wumu-dot/pointer-desk/docs/features/INDEX.md

# 功能开发总览

| ID | 功能描述 | 优先级 | 当前阶段 | 总体状态 | 审查结论 | 文件 |
|----|---|---|---|---|---|---|
| FEAT-20260620-001 | SHT30 集成 — temp_mode 4页重构（天气→湿度计→双温对比→设备信息）+ pointer_set_humidity | P1 | 🟢已完成 | 🟢已完成 | ✅通过 | [FEAT-20260620-001-SHT30-温湿度传感器集成.md](FEAT-20260620-001-SHT30-温湿度传感器集成.md) |

状态图例：🔴未开始 / 🟡进行中 / 🟢已完成 / ⚠️已暂停
审查结论：待审查 / ✅通过 / ❌退回
