wumu-dot/pointer-desk/docs/bugs/BUG-20260623-002-en-overheat.md

# EN 硬接 GND 导致电机一直通电发烫

- **Bug ID**：BUG-20260623-002
- **严重等级**：P0-致命
- **发现日期**：2026-06-23
- **修复日期**：2026-06-23

## 现象描述
新 A4988 模块电机能转了，但空闲时电机持续发烫。EN 脚硬接 GND，48V 线圈持续通电。

## 复现步骤
1. EN 接 GND（低电平使能）
2. 上电后电机空闲状态
3. 10 分钟后手摸电机明显发烫

## 根因分析
EN 低电平 → A4988 始终输出电流锁住电机。即使 STEP 脉冲停止，A4988 维持线圈电流（自动半流模式）。长时间导致电机和芯片发热。

## 修复方案
- 硬件：EN 从 GND 拔下，改接 STM32 PA2
- 软件：freertos.c 中 `a4988_enable(true)` 只在 diff>10 需要移动时调用；`a4988_enable(false)` 在 diff<=10 到位后调用
- 自检结束后立即 `a4988_enable(false)` 释放电机

## 影响文件
- `firmware/Core/Src/freertos.c`（自检结束 + 正常循环 enable/disable 逻辑）
- `HANDOFF.md`、`CLAUDE.md`（接线文档更新）

## 验证方式
上电自检结束 → 电机断电（手拧不动→拧得动）→ 时钟更新角度时 diff>10 → 自动使能转完断电
