wumu-dot/pointer-desk/docs/bugs/BUG-20260610-003-sht30-missing.md

# SHT30 温湿度传感器未接

- **Bug ID**：BUG-20260610-003
- **严重等级**：P1-严重
- **发现日期**：2026-06-10
- **修复日期**：2026-06-21

## 现象描述
温度读数精度仅 ±5°C（回退至 STM32 内部 ADC），无本地湿度数据。

## 复现步骤
1. 上电运行
2. 串口日志显示 `[SHT30] Device not found at 0x44 (I2C2)`
3. `temp_sensor_read()` 回退到 `temp_adc_read_celsius()`（内部 ADC）

## 根因分析
SHT30 传感器硬件未连接。驱动程序完整（`temp_sensor.c`），自动探测失败后优雅降级至内部 ADC。

## 修复方案
SHT30 已到货，2026-06-21 完成接线和验证：
- **PF1 = SCL**、**PF0 = SDA**（I2C2，100kHz）
- 供电：面包板 +轨 3.3V，地址：0x44
- temp_mode 同步升级为 4 页架构（天气/湿度计/双温对比/设备信息）
- FEAT-20260620-001 记录完整实施过程

**无需改驱动**。`sht30_init()` 上电自动探测，检测到即切换为 ±0.3°C 精度。

## 影响文件
- 无（驱动已就绪，插上即用）

## 验证方式
接好 SHT30 后上电，串口日志显示 `[SHT30] Device detected at 0x44 (I2C2)` 和 `[TEMP] Selected SHT30 (external, ±0.3°C)`。已验证通过。
