wumu-dot/pointer-desk/docs/bugs/BUG-20260610-001-tft-tearing.md

# TFT 显示闪烁（撕裂/Tearing）

- **Bug ID**：BUG-20260610-001
- **严重等级**：P0-阻断
- **发现日期**：2026-06-10
- **修复日期**：—

## 现象描述
时钟每秒刷新时，屏幕可见闪烁/撕裂线。

## 复现步骤
1. 上电运行，观察时钟模式每秒刷新
2. 可见水平撕裂线随秒刷新移动

## 根因分析
ST7735S 支持 TE（Tearing Effect）硬件同步信号（芯片第 14 脚），但 1.8 寸公版模块**未引出 TE 引脚**到排针。无 TE 信号时，SPI 写入 GRAM 与面板扫描异步 → 必然撕裂。

已尝试的软件缓解（均无法根治）：SPI 降频 21→10.5MHz、帧缓冲+选择性渲染（每秒只 flush ~2.3KB）、脏矩形合并。

## 修复方案
1. **飞线 TE 引脚**（推荐）：ST7735S 第 14 脚飞线到 STM32 空闲 GPIO，`flush_rect()` 前轮询 TE
2. 提高刷新率至 20FPS（功耗增加）
3. 接受现状（公版模块硬件限制）

## 影响文件
- `firmware/Drivers/BSP/lcd/st7735.c`
- `firmware/Drivers/BSP/lcd/st7735.h`

## 验证方式
飞线后：肉眼观察无撕裂线；20FPS 模式：串口日志帧率 ≥20
