wumu-dot/pointer-desk/docs/bugs/BUG-20260610-002-rtc-power-loss.md

# RTC 断电后时间丢失

- **Bug ID**：BUG-20260610-002
- **严重等级**：P3-轻微
- **发现日期**：2026-06-10
- **修复日期**：—

## 现象描述
断电后 RTC 时间归零，需重新编译/烧录注入时间。

## 复现步骤
1. 上电运行，确认时间正常
2. 完全断电（拔掉 Type-C + 3.3V）
3. 重新上电，RTC 时间归零

## 根因分析
VBAT 引脚未接备用电池，主电源断电后 RTC 寄存器和备份域全部丢失。

## 修复方案
接 CR1220 纽扣电池（3V）到 VBAT 引脚（LQFP144 第 6 脚），正极→VBAT，负极→GND。

**已缓解**：ESP32 NTP 每 60s 通过 UART 校准 STM32 RTC，上电后 60s 内自动对时。

## 影响文件
- 无代码改动（纯硬件）

## 验证方式
断电 1 分钟后重新上电，观察串口日志中 `weather frame` 到来前后的时间变化
