wumu-dot/pointer-desk/firmware/Core/Src/main.c

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
/* Includes ------------------------------------------------------------------*/
#include "main.h"
#include "cmsis_os.h"

/* USER CODE BEGIN Includes */
#include "pin_config.h"
#include "app_config.h"
#include "st7735.h"
#include "w25q64.h"
#include "a4988.h"
#include "button.h"
#include "temp_sensor.h"
#include "rtc_drv.h"
#include "gui.h"
#include "pointer_engine.h"
#include "fs_mgr.h"
#include "mode_manager.h"
#include "tasks.h"
/* USER CODE END Includes */

ADC_HandleTypeDef hadc1;

I2C_HandleTypeDef hi2c2;

RTC_HandleTypeDef hrtc;

SPI_HandleTypeDef hspi1;
SPI_HandleTypeDef hspi2;

TIM_HandleTypeDef htim2;
TIM_HandleTypeDef htim3;
TIM_HandleTypeDef htim4;
TIM_HandleTypeDef htim5;

UART_HandleTypeDef huart1;

/* Definitions for TaskButton */
osThreadId_t TaskButtonHandle;
const osThreadAttr_t TaskButton_attributes = {
  .name = "TaskButton",
  .stack_size = 512 * 4,
  .priority = (osPriority_t) osPriorityHigh,
};
/* Definitions for TaskBG */
osThreadId_t TaskBGHandle;
const osThreadAttr_t TaskBG_attributes = {
  .name = "TaskBG",
  .stack_size = 2048 * 4,
  .priority = (osPriority_t) osPriorityNormal,
};
/* Definitions for TaskDisplay */
osThreadId_t TaskDisplayHandle;
const osThreadAttr_t TaskDisplay_attributes = {
  .name = "TaskDisplay",
  .stack_size = 2048 * 4,
  .priority = (osPriority_t) osPriorityNormal,
};
/* Definitions for TaskMotor */
osThreadId_t TaskMotorHandle;
const osThreadAttr_t TaskMotor_attributes = {
  .name = "TaskMotor",
  .stack_size = 1024 * 4,
  .priority = (osPriority_t) osPriorityNormal,
};
/* Definitions for QueueBtnEvents */
osMessageQueueId_t QueueBtnEventsHandle;
const osMessageQueueAttr_t QueueBtnEvents_attributes = {
  .name = "QueueBtnEvents"
};
/* Definitions for QueueRenderCmds */
osMessageQueueId_t QueueRenderCmdsHandle;
const osMessageQueueAttr_t QueueRenderCmds_attributes = {
  .name = "QueueRenderCmds"
};
/* Definitions for QueueMotorTargets */
osMessageQueueId_t QueueMotorTargetsHandle;
const osMessageQueueAttr_t QueueMotorTargets_attributes = {
  .name = "QueueMotorTargets"
};
/* Definitions for EvtMotor */
osEventFlagsId_t EvtMotorHandle;
const osEventFlagsAttr_t EvtMotor_attributes = {
  .name = "EvtMotor"
};
/* USER CODE BEGIN PV */
UART_HandleTypeDef huart2;
DMA_HandleTypeDef hdma_usart2_rx;

/* USART2 DMA 接收缓冲区 (ESP32 天气桥接) */
uint8_t  uart2_rx_buf[256];
char     uart2_line_buf[128];
uint8_t  uart2_line_pos;
uint32_t uart2_dma_prev;

weather_data_t g_weather;

/* SPI1 DMA TX handle — needed by stm32f4xx_it.c DMA2_Stream3_IRQHandler */
DMA_HandleTypeDef hdma_spi1_tx;
/* USER CODE END PV */

void SystemClock_Config(void);
static void MX_GPIO_Init(void);
static void MX_SPI1_Init(void);
static void MX_SPI2_Init(void);
static void MX_TIM2_Init(void);
static void MX_TIM3_Init(void);
static void MX_TIM4_Init(void);
static void MX_ADC1_Init(void);
static void MX_I2C2_Init(void);
static void MX_RTC_Init(void);
static void MX_TIM5_Init(void);
static void MX_USART1_UART_Init(void);
static void MX_USART2_UART_Init(void);
void StartTaskButton(void *argument);
void StartTaskBG(void *argument);
void StartTaskDisplay(void *argument);
void StartTaskMotor(void *argument);

/**
  * @brief  The application entry point.
  * @retval int
  */
int main(void)
{

  /* MCU Configuration--------------------------------------------------------*/

  /* Reset of all peripherals, Initializes the Flash interface and the Systick. */
  HAL_Init();

  /* Configure the system clock */
  SystemClock_Config();

  /* Initialize all configured peripherals */
  MX_GPIO_Init();
  MX_SPI1_Init();
  MX_SPI2_Init();
  MX_TIM2_Init();
  MX_TIM3_Init();
  MX_TIM4_Init();
  MX_ADC1_Init();
  MX_I2C2_Init();
  MX_RTC_Init();
  MX_TIM5_Init();
  MX_USART1_UART_Init();
  MX_USART2_UART_Init();
  /* USER CODE BEGIN 2 */
  LOG("========== OV-Watch Firmware v1.0.0 ==========\r\n");
  LOG("System Core Clock: %lu MHz\r\n", SystemCoreClock / 1000000);

  /* ---- USART2 DMA 启动 — ESP32 天气数据 ---- */
  HAL_UART_Receive_DMA(&huart2, uart2_rx_buf, sizeof(uart2_rx_buf));

  /* ---- BSP 驱动初始化 ---- */
  st7735_init();
  button_init();
  a4988_init();
  temp_sensor_init();
  /* w25q64 由 fs_mgr 模块延迟检测 (FreeRTOS 启动后) */

  /* ---- 中间件初始化 ---- */
  gui_init();
  pointer_engine_init();

  /* ---- 应用层初始化 ---- */
  mode_manager_init();

  /* ---- 背光 PWM 启动 ---- */
  HAL_TIM_PWM_Start(&htim3, TIM_CHANNEL_3);
  st7735_set_brightness(LCD_BRIGHTNESS_DEFAULT);

  LOG("Hardware init complete, starting scheduler...\r\n");
  /* USER CODE END 2 */

  /* Init scheduler */
  osKernelInitialize();

  /* USER CODE BEGIN RTOS_MUTEX */
  /* add mutexes, ... */
  /* USER CODE END RTOS_MUTEX */

  /* USER CODE BEGIN RTOS_SEMAPHORES */
  /* add semaphores, ... */
  /* USER CODE END RTOS_SEMAPHORES */

  /* USER CODE BEGIN RTOS_TIMERS */
  /* start timers, add new ones, ... */
  /* USER CODE END RTOS_TIMERS */

  /* Create the queue(s) */
  /* creation of QueueBtnEvents */
  QueueBtnEventsHandle = osMessageQueueNew (8, 8, &QueueBtnEvents_attributes);

  /* creation of QueueRenderCmds */
  QueueRenderCmdsHandle = osMessageQueueNew (16, 16, &QueueRenderCmds_attributes);

  /* creation of QueueMotorTargets */
  QueueMotorTargetsHandle = osMessageQueueNew (4, 12, &QueueMotorTargets_attributes);

  /* USER CODE BEGIN RTOS_QUEUES */
  /* add queues, ... */
  /* USER CODE END RTOS_QUEUES */

  /* Create the thread(s) */
  /* creation of TaskButton */
  TaskButtonHandle = osThreadNew(StartTaskButton, NULL, &TaskButton_attributes);

  /* creation of TaskBG */
  TaskBGHandle = osThreadNew(StartTaskBG, NULL, &TaskBG_attributes);

  /* creation of TaskDisplay */
  TaskDisplayHandle = osThreadNew(StartTaskDisplay, NULL, &TaskDisplay_attributes);

  /* creation of TaskMotor */
  TaskMotorHandle = osThreadNew(StartTaskMotor, NULL, &TaskMotor_attributes);

  /* USER CODE BEGIN RTOS_THREADS */
  /* add threads, ... */
  /* USER CODE END RTOS_THREADS */

  /* Create the event(s) */
  /* creation of EvtMotor */
  EvtMotorHandle = osEventFlagsNew(&EvtMotor_attributes);

  /* USER CODE BEGIN RTOS_EVENTS */
  /* add events, ... */
  /* USER CODE END RTOS_EVENTS */

  /* Start scheduler */
  osKernelStart();

  /* We should never get here as control is now taken by the scheduler */

  /* Infinite loop */
  /* USER CODE BEGIN WHILE */
  while (1)
  {
    /* USER CODE END WHILE */

    /* USER CODE BEGIN 3 */
  }
  /* USER CODE END 3 */
}

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
/* USER CODE BEGIN 4 */
#include <stdio.h>

/* printf 重定向到 USART1 (Keil ARMCC + GCC 通用) */
#if defined(__GNUC__) && !defined(__CC_ARM)
/* GCC / Newlib-nano */
int _write(int fd, char *ptr, int len) {
    HAL_UART_Transmit(&huart1, (uint8_t *)ptr, len, HAL_MAX_DELAY);
    return len;
}
#else
/* Keil ARMCC (MicroLIB 或标准库) */
int fputc(int ch, FILE *f) {
    (void)f;
    HAL_UART_Transmit(&huart1, (uint8_t *)&ch, 1, HAL_MAX_DELAY);
    return ch;
}
#endif
/* USER CODE END 4 */

/* USER CODE BEGIN Header_StartTaskButton */
/**
  * @brief  Function implementing the TaskButton thread.
  * @param  argument: Not used
  * @retval None
  */
/* USER CODE END Header_StartTaskButton */

/* GCC: StartTask* implementations live in freertos.c.
   ARMCC: CubeMX stubs in main.c (Keil uses freertos.c too, but linker picks
   the first definition — ARMCC linker semantics differ from GCC). */
#ifndef __GNUC__

void StartTaskButton(void *argument)
{
  /* USER CODE BEGIN 5 */
  /* Infinite loop */
  for(;;)
  {
    osDelay(1);
  }
  /* USER CODE END 5 */
}

/* USER CODE BEGIN Header_StartTaskBG */
/**
* @brief Function implementing the TaskBG thread.
* @param argument: Not used
* @retval None
*/
/* USER CODE END Header_StartTaskBG */
void StartTaskBG(void *argument)
{
  /* USER CODE BEGIN StartTaskBG */
  /* Infinite loop */
  for(;;)
  {
    osDelay(1);
  }
  /* USER CODE END StartTaskBG */
}

/* USER CODE BEGIN Header_StartTaskDisplay */
/**
* @brief Function implementing the TaskDisplay thread.
* @param argument: Not used
* @retval None
*/
/* USER CODE END Header_StartTaskDisplay */
void StartTaskDisplay(void *argument)
{
  /* USER CODE BEGIN StartTaskDisplay */
  /* Infinite loop */
  for(;;)
  {
    osDelay(1);
  }
  /* USER CODE END StartTaskDisplay */
}

/* USER CODE BEGIN Header_StartTaskMotor */
/**
* @brief Function implementing the TaskMotor thread.
* @param argument: Not used
* @retval None
*/
/* USER CODE END Header_StartTaskMotor */
void StartTaskMotor(void *argument)
{
  /* USER CODE BEGIN StartTaskMotor */
  /* Infinite loop */
  for(;;)
  {
    osDelay(1);
  }
  /* USER CODE END StartTaskMotor */
}

#endif /* !__GNUC__ */

/**
  * @brief  Period elapsed callback in non blocking mode
  * @note   This function is called  when TIM6 interrupt took place, inside
  * HAL_TIM_IRQHandler(). It makes a direct call to HAL_IncTick() to increment
  * a global variable "uwTick" used as application time base.
  * @param  htim : TIM handle
  * @retval None
  */
void HAL_TIM_PeriodElapsedCallback(TIM_HandleTypeDef *htim)
{
  if (htim->Instance == TIM6)
  {
    HAL_IncTick();
  }
}

/**
  * @brief  This function is executed in case of error occurrence.
  * @retval None
  */
void Error_Handler(void)
{
  /* USER CODE BEGIN Error_Handler_Debug */
  /* User can add his own implementation to report the HAL error return state */
  __disable_irq();
  while (1)
  {
  }
  /* USER CODE END Error_Handler_Debug */
}
#ifdef USE_FULL_ASSERT
/**
  * @brief  Reports the name of the source file and the source line number
  *         where the assert_param error has occurred.
  * @param  file: pointer to the source file name
  * @param  line: assert_param error line source number
  * @retval None
  */
void assert_failed(uint8_t *file, uint32_t line)
{
  /* USER CODE BEGIN 6 */
  /* User can add his own implementation to report the file name and line number,
     ex: printf("Wrong parameters value: file %s on line %d\r\n", file, line) */
  /* USER CODE END 6 */
}
#endif /* USE_FULL_ASSERT */
