wumu-dot/pointer-desk/firmware/Core/Inc/main.h

#define CS_Pin GPIO_PIN_4
#define CS_GPIO_Port GPIOA
#define DC_Pin GPIO_PIN_4
#define DC_GPIO_Port GPIOC
#define RST_Pin GPIO_PIN_5
#define RST_GPIO_Port GPIOC
#define CSB12_Pin GPIO_PIN_12
#define CSB12_GPIO_Port GPIOB
