wumu-dot/pointer-desk/(commit log)

2026-06-15 ov-watch: 固件编译通过 + 18个运行时bug修复 + 单键适配
    ## 编译修复
    - main.c 删除CubeMX空壳函数定义, 用freertos.c实现
    - uvprojx 关闭DebugInformation (ARMCC V5 32位 out of store)
    - fs_mgr.c em dash → ASCII
    - gui.c 0b二进制 → 0x十六进制 (ARMCC不支持0b)
    - temp_adc.c ADC_REGULAR_RANK_1 → 1 (F4无此宏)
    - a4988.c BRR→BSRR, 宏→寄存器
    - st7735.c 移除unused变量, w25q64.c注释unused函数
    - 4个mode头文件添加 #include "button.h"
    ## 运行时修复
    - #17 st7735_draw_char 字模行列颠倒修正
    - #18 pointer_set_target LOG去重
    - #19 clock_mode_render 冗余脏矩形标记清理
    - #20 freertos.c 电机反馈回路删除 (指针不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
    [app_config.h, clock_mode.c, clock_mode.h, main.c, main.h, mode_manager.c, mode_manager.h, ov-watch.ioc]
2026-06-17 docs: esp32 weather bridge design spec
2026-06-17 docs: esp32 weather bridge implementation plan (16 tasks, 4 phases)
2026-06-17 fix(fs_mgr): Flash 空间泄漏 — fs_config_save 由强制追加改为原地覆写
    根因: fs_config_save() 无条件使用 g_next_data_offset 写入数据，
    每次保存配置文件都追加到队尾，旧数据原地废弃。g_next_data_offset
    只进不退，导致配置区空间被无意义消耗。
    修复:
    - 已存在且新数据 ≤ 旧数据大小 → 原地覆写，不推进偏移
    - 新增 key 或数据变大 → 追加到队尾，推进偏移
    - 空间检查仅对追加写入场景执行
    - LOG 追加 [new]/[grew]/[in-place] 标记，方便调试
    其他改动:
    - 新增交接文档 (HANDOFF.md)、Bug 清单 (BUGS.md)
    - 新增 weather_bridge.c/h (ESP32 UART 天气桥接 DMA 解析)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
    [app_config.h, clock_mode.c, main.c, main.h, mode_manager.c, pin_config.h, settings_mode.c, temp_mode.c]
2026-06-20 chore: 项目结构清理 + Bug体系迁移 + 文档重构
    项目结构：
    - 删除 firmware/EWARM/ (IAR项目，本项目用Keil MDK)
    - 删除 firmware/Middlewares/ (FreeRTOS冗余副本，由Keil RTE管理)
    - 删除 START_HERE.md (过时，内容已由README+HANDOFF覆盖)
    - 删除 docs/cubemx-setup.md + docs/stm32f407-constraints.md (引脚信息错误)
    Bug体系迁移：
    - BUGS.md (155行单文件) → docs/bugs/ (一Bug一文件 + INDEX.md)
    - 8个未修复 + 1个已修复 + 模板
    文档重构：
    - CLAUDE.md 重写为项目地图 (技术栈/目录速查/约束/规范索引)
    - HANDOFF.md 更新v1.4.1 (清理记录/电机SHT30状态/A4988数据手册)
    - README.md 重写为精简版
    -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
2026-06-20 fix: 恢复 FreeRTOS 源码 — Keil 工程引用本地路径非 RTE Pack
    之前清理时误删 firmware/Middlewares/Third_Party/FreeRTOS/Source/，
    以为 Keil RTE Pack 管理了这些文件。实际上 ov-watch.uvprojx 直接引用
    ../Middlewares/Third_Party/FreeRTOS/Source/ 本地路径，删除后编译报
    'cannot open source input file' ×12。
    修正 CLAUDE.md 中错误描述："FreeRTOS 源码副本，由 Keil RTE Pack 管理"
    → "FreeRTOS 源码，Keil 工程直接引用本地路径，勿删"。
2026-06-20 feat: SHT30 温湿度传感器集成 — temp_mode 4页架构重构
    FEAT-20260620-001 完成。SHT30 已接线验证通过 (I2C2 PF0/PF1 0x44)。
    代码改动:
    - pointer_engine.h/c: 新增 pointer_set_humidity() — 0-100% 映射 30°-330° 弧线
    - temp_mode.c: bool→enum 4页架构 (天气→湿度计→双温对比→设备信息)
    - 湿度计子页: SHT30 本地湿度 → 大字+等级标签+湿度环+指针
    - 双温对比子页: LOCAL(SHT30) vs REGIONAL(ESP32) 温度+湿度+温差
    - SHT30 离线降级: 湿度计显示 '--%' + 'No SHT30'
    双温对比 LOCAL 显示 '--.-' + 'None'
    测试:
    - TC01 SHT30在线: 4页全正常，指针角度正确
    - TC02 SHT30离线: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
2026-06-20 docs: README 重写 — 更名为 pointer-desk，更新项目状态
    反映 SHT30 已完成、4页架构已就绪，新增功能看板链接。
    待实现项: 电机验证 / 番茄钟 / 呼吸引导 / 日出日落环
2026-06-20 docs: README 加个人后记 — AI 协作心得
2026-06-20 docs: FEAT 模板升级 v3.1 — 5阶段重命名 + 12条AC + 阶段间停等
    阶段重命名 (更语义化):
    阶段1 基础框架搭建 → 准备 (分析依赖, 输出影响范围)
    阶段2 核心业务逻辑 → 设计 (数据结构, 接口签名)
    阶段3 集成与自测 → 实现 (写代码, 对照AC自检)
    阶段4 独立测试 → 测试 (只看规格, 不看实现)
    阶段5 独立审查 → 审查 (安全检查/质量/规范 唯一下闸)
    新增:
    - 每个阶段末尾加 ⏸️ 停等标记 (阶段间必须等人说继续)
    - AC 从 11 条扩展为 12 条 (AC-12: 按 FEAT 模板执行)
    - AC-03/04 拆分: 编译Lint / 无新增警告
    - AC-05 函数行数 →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
2026-06-20 ci: GitHub Actions 质量门禁 — 4道自动检查
    每次 push 到 C 源文件自动触发:
    Job 1: check-firmware.sh (18项回归)
    Job 2: 硬编码密钥扫描 (sk-xxx / API_KEY / password / token)
    Job 3: 危险函数扫描 (sprintf/strcpy/strcat/gets/scanf — 排除vendor)
    Job 4: 文件行数检查 (max 800行 — 排除CubeMX main.c + vendor)
    仅扫描项目代码 (App/Core/BSP/Middleware)，排除 FreeRTOS/CMSIS/HAL。
2026-06-20 fix: CI 移除 path filter — 首次创建工作流文件不触发
2026-06-21 feat(build): 迁移到 STM32CubeCLT (GCC) — 脱离 Keil 许可证
    CubeMX 切换 Toolchain: MDK-ARM → Makefile
    - Makefile (CubeMX 生成 + 自定义源文件/头文件路径)
    - startup_stm32f407xx.s (GCC 汇编启动文件)
    - STM32F407XX_FLASH.ld (链接脚本)
    - build_and_flash.bat (一键编译+烧录)
    - syscalls.c / sysmem.c (GCC semihosting stubs)
    - FreeRTOS GCC port (portable/GCC/ARM_CM4F)
    修改:
    - main.c: StartTask* stubs 加 __ARMCC_VERSION guard
    - main.c: 补充 hdma_spi1_tx 定义
    - CLAUDE.md: 编译命令补充 GCC 工具链
    编译: arm-none-eabi-gcc 14.3.1 → 0 Error
    硬件验证: SHT30/TFT/Flash/RTC/按键 全部正常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
    [main.c, ov-watch.ioc]
2026-06-21 ci: Quality Gate 新增 Job 5 — GCC 编译验证
    make -j(nproc) 每次 push 自动编译 STM32F407 固件。
    使用 Ubuntu APT 的 gcc-arm-none-eabi 工具链 (~250MB)。
    现在 5 道检查:
    1. check-firmware.sh (18项回归)
    2. 硬编码密钥扫描
    3. 危险函数扫描
    4. 文件行数检查
    5. GCC 编译 ✅ ← 新增
2026-06-21 fix(ci): check-firmware.sh StartTask 检查适配 GCC guard
    GCC 迁移后 main.c 中 StartTask* 函数体被 #ifndef __GNUC__ 包裹
    (ARMCC-only stubs)。旧检查将所有非声明行一律判 FAIL。
    修复: 检查 StartTask 体是否在 GCC guard 内 — 在则 PASS。
2026-06-21 fix(build): 恢复 USART2 初始化和 DMA — CubeMX 重新生成后丢失
    CubeMX 不知道 ESP32 天气桥接用的 USART2 (手动添加的外设)，
    切换 Makefile 重新生成时删除了:
    - main.c: MX_USART2_UART_Init() 函数和调用
    - hal_msp.c: USART2 GPIO/DMA 初始化 (PD5/PD6, DMA1_Stream5)
    恢复后 ESP32 天气数据 (时间/温度/湿度/描述) 正常接收。
    [main.c]
2026-06-21 fix(build): GCC nano.specs 浮点格式化 + check-firmware.sh temp_mode 变量名
    GCC nano.specs 默认禁用 snprintf 浮点格式化 (%f/%.1f)，
    导致日志中角度打印为空。添加 -u _printf_float 恢复。
    check-firmware.sh: temp_mode.c 4页重构后变量 no longer maps
    'last_rendered' → 'last_rendered_weather'，更新检查正则。
2026-06-21 fix(build): GCC nano.specs 禁用浮点 scanf — ESP32 天气帧解析恢复
    根因: -specs=nano.specs 默认裁剪 scanf 浮点格式化，
    sscanf(frame, "%f", &temp) 静默失败 → matched<9 → return
    导致 g_weather 永远不更新 + RTC 不校准。
    修复: LDFLAGS 加 -u _scanf_float (与 _printf_float 配对)
    代码段增加 ~10KB，浮点 printf+scanf 全恢复。
    Bug记录:
    BUG-20260621-001: nano.specs printf/scanf 浮点丢失
    BUG-20260621-002: CubeMX 重新生成丢失 USART2 初始化
2026-06-22 feat(debug): GDB + ST-Link GDB Server 调试环境
    利用 CubeCLT 自带的 ST-LINK_gdbserver (v7.13.0)，无需安装 OpenOCD。
    双终端方案:
    终端1: ST-LINK_gdbserver.exe (守护进程, 端口 61234)
    终端2: arm-none-eabi-gdb build/ov-watch.elf
    一键方案:
    双击 gdb_debug.bat → 自动启动服务器+GDB+烧录+停在main
    常用命令: b=断点, c=运行, n=跳过, s=进入, p var=打印, bt=栈回溯
2026-06-22 feat(debug): OpenOCD + GDB 调试环境，项目迁移至纯英文路径
    - 新增 openocd.cfg (st-link/swd/stm32f4x)，替代 ST-Link GDB Server
    - 新增 openocd_debug.bat 一键启动 OpenOCD + GDB 调试
    - 更新 gdb_debug.bat 适配端口 7184，简化路径配置
    - 精简 .gdbinit，自动连接 OpenOCD :3333
    - 新增 .gitignore 排除编译产物 (.o/.crf/.axf/.hex 等)
    - 更新 README.md 为展示版
    - 更新 Keil 工程文件和 CubeMX 配置
2026-06-22 docs(README): 展示跨平台 GCC 编译 + CI Quality Gate
    - 新增 GCC | ARMCC 编译 badge + GitHub Actions 动态 badge
    - 快速开始改为跨平台优先（make 一键编译，无需 Keil 许可证）
    - 新增 OpenOCD + GDB 一键调试入口
    - 新增 CI/Quality Gate 章节（5 道自动检查）
    - Keil MDK 保留为备选方案
2026-06-23 feat(motor): A4988 驱动完善 + 一键编译/烧录/调试脚本 + 文档更新
    - a4988: PWM 停止前清零 CCR 防止 STEP 悬空电平; 新增步数累计函数
    - freertos: StartTaskMotor 入口使能电机，添加启动自检
    - build_and_flash.bat: 统一绝对路径，解决 PATH 变量解析错误
    - flash.bat: 新增 ISP 串口烧录脚本
    - gdb_debug.bat / openocd_debug.bat: 修复路径引用
    - README: 工作流三步骤（编译→烧录→调试）+ CI badge
    - HANDOFF: A4988 模块引脚/电源/调试记录完整章节
    - CLAUDE: 烧录方式/调试环境/引脚规则更新
    - jiaocheng.md: CodeGraph + OpenOCD + GDB 调试教程
2026-06-23 feat(modes): 新增番茄钟 + 呼吸引导模式
    - 番茄钟: 25分钟工作 + 5分钟休息自动循环，进度环配色区分工作/休息，长按重置
    - 呼吸引导: 4-7-8 呼吸法圆圈动画 (CYAN→GREEN→ORANGE)，实时倒计时显示
    - 倒计时: 断开电机依赖，结束时用 TFT 闪烁替代震动
    - mode_manager: 扩展为 6 模式 (Clock/Temp/Timer/Pomodoro/Breathe/Settings)
    - 短按循环切换，无按键冲突
2026-06-26 fix(motor): 新A4988模块电机正常运转，EN空闲禁用防过热
    - EN 改回 PA2 控制：自检后拉高断电，正常循环到位即断电
    - #if 0 移除：恢复指针引擎闭环伺服（硬纸片指针已装上）
    - 时钟模式驱动：angle→步数→diff 控制，分钟级微调
    - TFT 从适配器3.3V直供（脱离 STM32 LDO 限流）
    - HANDOFF: 完整接线+供电拓扑+EN逻辑文档更新
    [breathe_mode.c, pomodoro_mode.c, timer_mode.c]
2026-06-26 fix(clock): 指针每30分钟更新一次，减少电机微动
    - clock_mode_update 改为半小时桶判断 (hours*2 + minute/30)
    - 同桶内跳过 pointer_set_clock，电机不转
    - 24h制: 每小时15°，半小时=7.5°，diff足够触发一次电机移动
    [clock_mode.c]
2026-06-26 fix(modes): Timer/番茄钟黑屏修复 + 指针半小时更新
    - timer/番茄钟: enter() 重置 render_cache，防止去重误判跳过首次渲染
    - clock: 指针每30分钟更新一次 (bucket = hours*2 + minute/30)
    [pomodoro_mode.c, timer_mode.c]
2026-06-26 docs(CLAUDE): 添加 Git/CI 工作流规范、GDB 调试策略、电机控制规则
2026-06-26 docs(CLAUDE): 调试策略 — CodeGraph 地图定位 + OpenOCD + GDB 三步法
2026-06-26 迁移前快照：规范体系v3.2 + 15条bug记录
2026-06-29 docs: HANDOFF v2.0 重写 + 15条bug记录 + GDB 调试体系 + .gdbinit extended-remote
    - HANDOFF: 全量重写为 v2.0，6模式、电机验证通过、GDB 寄存器速查表
    - .gdbinit: target remote → extended-remote (兼容新版 OpenOCD)
    - Bug: 新增 5 条 (A4988供电/EN过热/TFT掉压/Makefile污染/时钟秒刷新)
    - Bug: 更新 2 条旧记录 (电机已验证/Timer黑屏修正为 render_cache)
    - CLAUDE: 调试三步法 + Git/CI 工作流规范
2026-06-29 docs(README): 电机状态更新 — 正常运转，六模式
2026-06-29 fix(build): SPI1 分频恢复为 8 (10.5MHz)，同步 .ioc 文件
    [main.c, ov-watch.ioc]
2026-06-29 feat(keys): PB6-9 四键导航 — 上/下切模式，右确认，左返回
    - pin_config: 按键移至 PB6(上)/PB7(下)/PB8(左)/PB9(右)
    - main.c: MX_GPIO_Init 新增 PB6-9 INPUT_PULLUP
    - mode_manager: UP=上一模式 DOWN=下一模式 RIGHT=确认 LEFT=回时钟
    - 6个模式按钮处理器: SHORT RIGHT→确认动作, LONG→重置/退出
    - 底部提示文字全部更新为 RIGHT/LEFT 风格
    - CLAUDE/HANDOFF 引脚表同步
    [breathe_mode.c, clock_mode.c, main.c, mode_manager.c, pin_config.h, pomodoro_mode.c, settings_mode.c, temp_mode.c]
